FeiyuWang/Gesture-Controlled-Wrist-Worn-Display/readme.md

Gesture Controlled Wrist-Worn Display

File: live demo.mp4

This is the live demo of our device

File: Complete_Gesture_Sensor_Model.slx

Require add-on libarary Simscape for both Matlab and Simulink versions

File: Circuit_Diagram.slx

It is a circuit diagram design. Not a simulation.

File: Analog_Reading.slx

Requirs phisically connect to Arduino board and takes analog reading. 

File: Test.ino

This is the code for arduino IDE that we used for this project
